cubanmakers/COVID19Caudalimetro/files/VEN-B30-D22.STEP

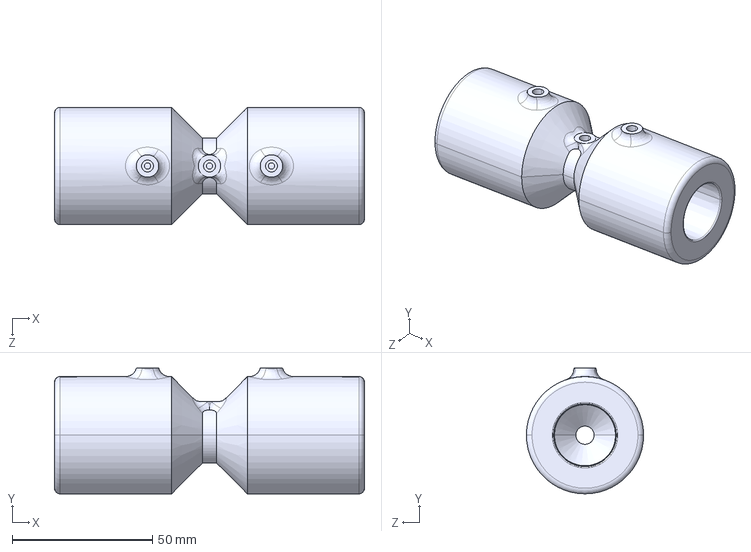
[picture p13: CAD file, 2020-04-13]
files/VEN-B30-D22.STEP
110.6 x 44.8 x 41.8 mm
