cubanmakers/COVID19Caudalimetro/files/VEN-B30-D22(simple).STEP

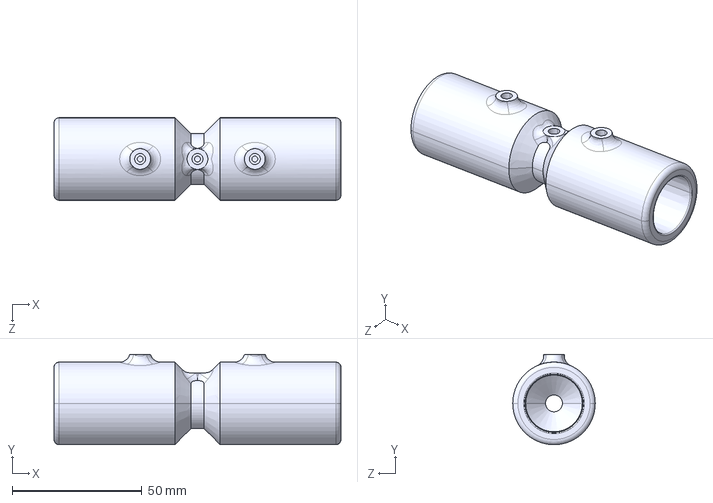
[picture p14: CAD file, 2020-04-13]
files/VEN-B30-D22(simple).STEP
110.6 x 34.8 x 31.8 mm
