cubanmakers/COVID19Caudalimetro/files/ORI-B33-D22.STEP

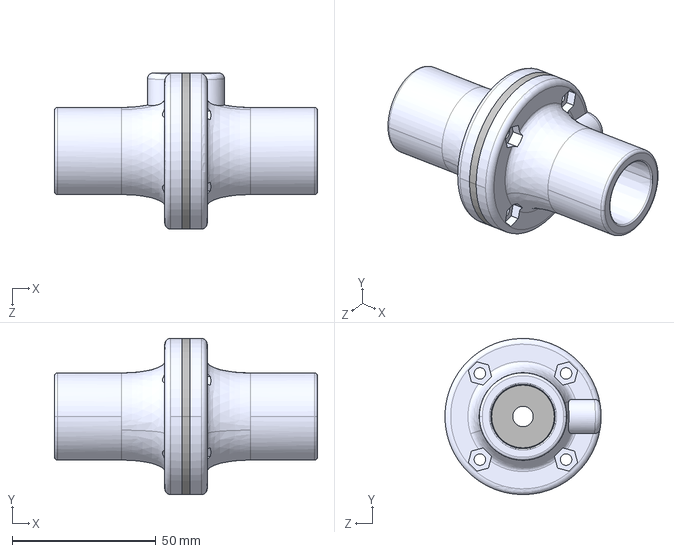
[picture p15: CAD file, 2020-04-13]
files/ORI-B33-D22.STEP
91.5 x 54.4 x 54.4 mm
