cubanmakers/COVID19Caudalimetro/files/VOM-B37-D20.STEP

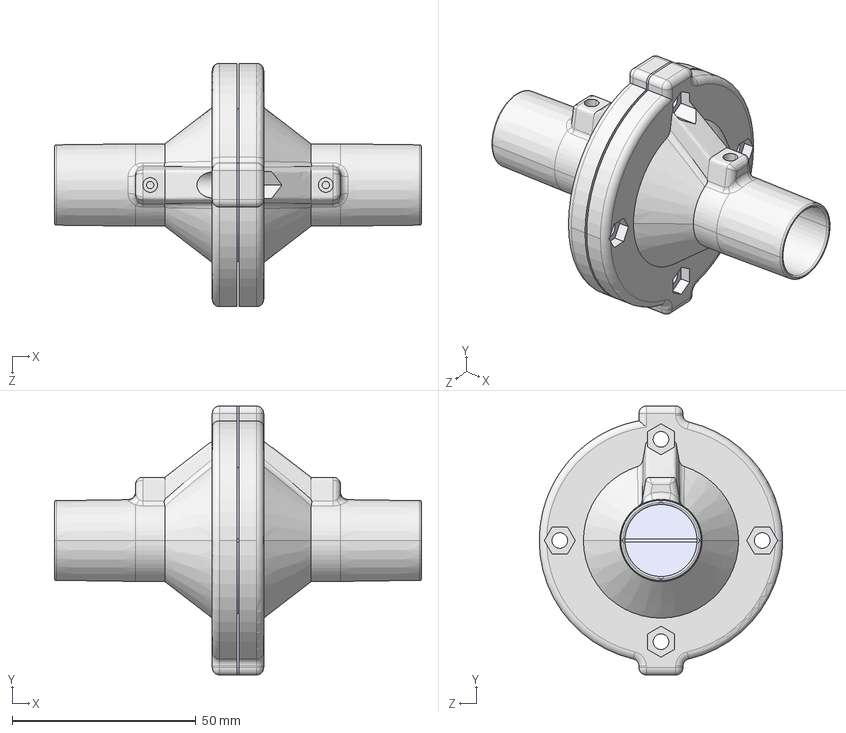
[picture p16: CAD file, 2020-04-13]
files/VOM-B37-D20.STEP
99.7 x 73.1 x 66.2 mm
