cubanmakers/COVID19Caudalimetro/(list of files, cad)

Other CAD files:
files/ORI-B33-D22.IGS
files/ORI-B33-D22.SLDPRT
files/ORI-B33-D22.x_t
files/VEN-B30-D22(simple).IGS
files/VEN-B30-D22(simple).SLDPRT
files/VEN-B30-D22(simple).x_t
files/VEN-B30-D22.IGS
files/VEN-B30-D22.SLDPRT
files/VEN-B30-D22.x_t
files/VOM-B37-D20.IGS
files/VOM-B37-D20.SLDPRT
files/VOM-B37-D20.x_t
